lanuzadev/espower/assets/E.jpeg

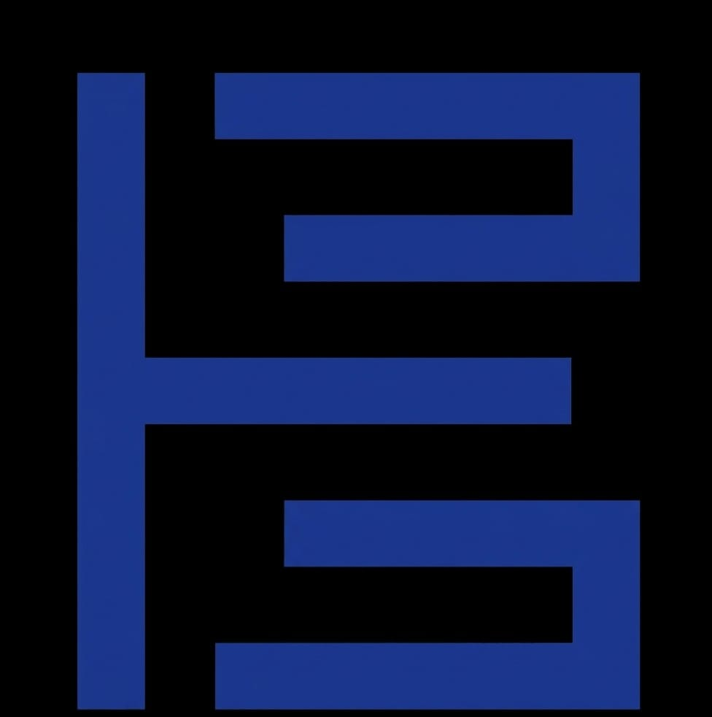
assets/E.jpeg
