lanuzadev/espower/assets/E.png

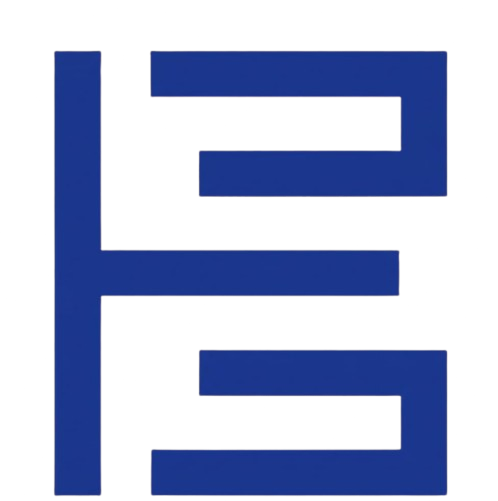
assets/E.png
