lanuzadev/espower/Firmware/Espower/config.local.example.h

#pragma once

// Copia este archivo como config.local.h y completa los valores localmente.
// No publiques config.local.h ni compartas la contraseña del dispositivo.
#define API_KEY ""
#define USER_EMAIL ""
#define USER_PASSWORD ""
#define DATABASE_URL ""
