lanuzadev/espower/(commit log)

2026-10-14 Publicar ESPower con firmware, circuito y documentación
2026-10-14 Corregir dirección visible de GitHub en contacto
2026-10-14 Aclarar alcance del formulario de contacto
2026-10-14 Mostrar primero la web en el recorrido del README
